Altitude-Unknown/YELLOWSTONE/LAB_NOTES_2026-06-30.md

# Yellowstone / SHERPA / ICARUS Lab Notes

Date: 2026-06-30

## What we verified

- Ground YELLOWSTONE firmware sends the cutdown command correctly.
- Ground now reports command send status in the form:
  `STATUS,CUTDOWN_SENT,<seq>,sent,<count>,timeouts,<count>`
- Airborne YELLOWSTONE receives the LoRa command and prints:
  `Command forwarded to SHERPA: CUTDOWN seq=<seq>`
- ICARUS did not receive any cutdown packet during today's end-to-end tests.

## Important fixes made today

- Ground firmware was updated so cutdown LoRa transmit does not hang forever in
  `waitPacketSent()`. It now uses a transmit timeout and reports send counts.
- Airborne firmware currently includes the larger receive window used for
  command testing.
- SHERPA PCB wiring issue was found: the UART lines had been effectively
  `TX -> TX` and `RX -> RX`.
- User corrected the SHERPA PCB/wiring before leaving the lab.

## Current conclusion

The command path is confirmed through:

- Ground USB command input
- Ground LoRa transmit
- Airborne LoRa receive
- Airborne UART output toward SHERPA

The remaining failure point is after Airborne prints
`Command forwarded to SHERPA`, meaning the likely problem area is:

- Airborne-to-SHERPA UART electrical connection
- SHERPA UART pin mapping / bridge behavior
- SHERPA ESP-NOW transmit
- ICARUS ESP-NOW receive

## Recommended first retest tomorrow

1. Connect Ground YELLOWSTONE to laptop over USB.
2. Power Airborne YELLOWSTONE with SHERPA attached.
3. Connect ICARUS to laptop over USB for monitoring.
4. Send one controlled cutdown command from Ground.
5. Watch for:
   - Ground: `STATUS,CUTDOWN_SENT,...`
   - Airborne: `Command forwarded to SHERPA...`
   - ICARUS: `ICARUS,CUTDOWN_RX...` and `ICARUS,CUTDOWN_ACTIVE...`

## Key firmware files

- `Ground_YELLOWSTONE_dev/Ground_YELLOWSTONE_dev.ino`
- `Airborne_YELLOWSTONE_dev/Airborne_YELLOWSTONE_dev.ino`
- `SHERPA_Cutdown_Bridge/SHERPA_Cutdown_Bridge.ino`
- `ICARUS_Cutdown_Receiver/ICARUS_Cutdown_Receiver.ino`
- `yellowstone_ground_station.py`

## 2026-07-01 UART correction

- Yellowstone PB22/PB23 are the SHERPA UART pins:
  - PB22 / SAMD21 package pin 37 / Arduino D30 = `Serial5` TX
  - PB23 / SAMD21 package pin 38 / Arduino D31 = `Serial5` RX
- The Feather M0 core's default `Serial1` is PA10/PA11 and does not reach the
  Yellowstone SHERPA UART connector.
- Two-Yellowstone UART diagnostics passed after switching from `Serial1` to
  `Serial5`:
  - `Yellowstone_UART_Ping_Talker`
  - `Yellowstone_UART_Ping_Responder`
- Airborne firmware was updated to forward `SHERPA,CUTDOWN,<sequence>` over
  `Serial5`.

## 2026-07-01 ICARUS acknowledgement path

- Added a reverse acknowledgement for cutdown commands:
  - ICARUS broadcasts an ESP-NOW ack after accepting a new cutdown sequence.
  - SHERPA receives `ICARUS,ACK,<sequence>,accepted,<count>` and forwards it
    to Airborne over the Yellowstone UART.
  - Airborne repeats a compact LoRa ack packet back to Ground.
  - Ground prints `STATUS,ICARUS_ACK,<sequence>,accepted,<count>,rssi,<rssi>`.
  - The GUI displays the ICARUS ack in the Cutdown panel and status bar.
- Ground transmits the cutdown command for about three seconds, so Airborne
  repeats the ack for several seconds to avoid the ack arriving only while
  Ground is still transmitting.
