Altitude-Unknown/YELLOWSTONE/SHERPA.pdf

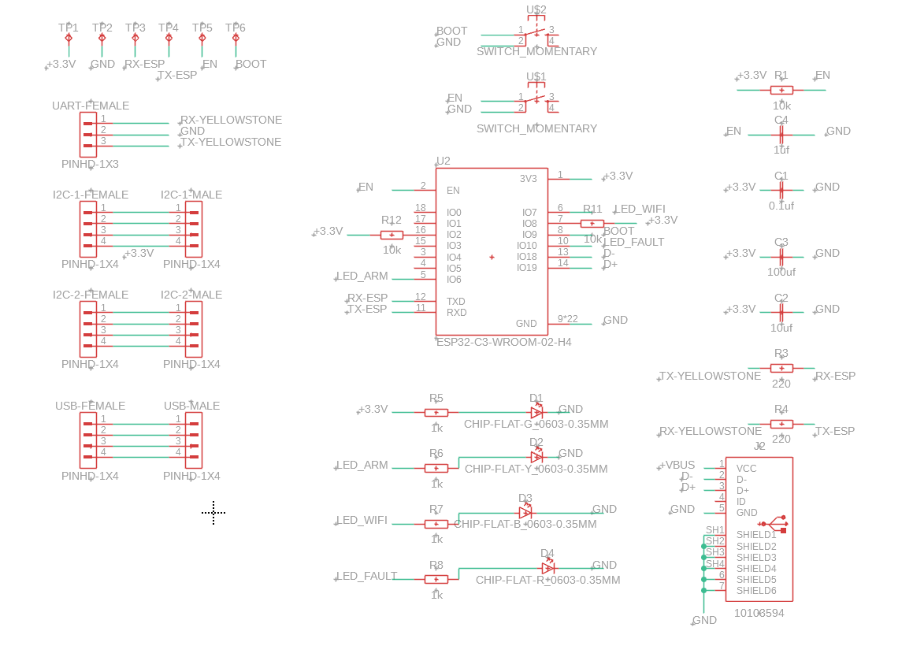
[picture p1: page 1]
