Altitude-Unknown/YELLOWSTONE/Schematic_ICARUS_cutdownSCHEMATIC_V1_DG.png

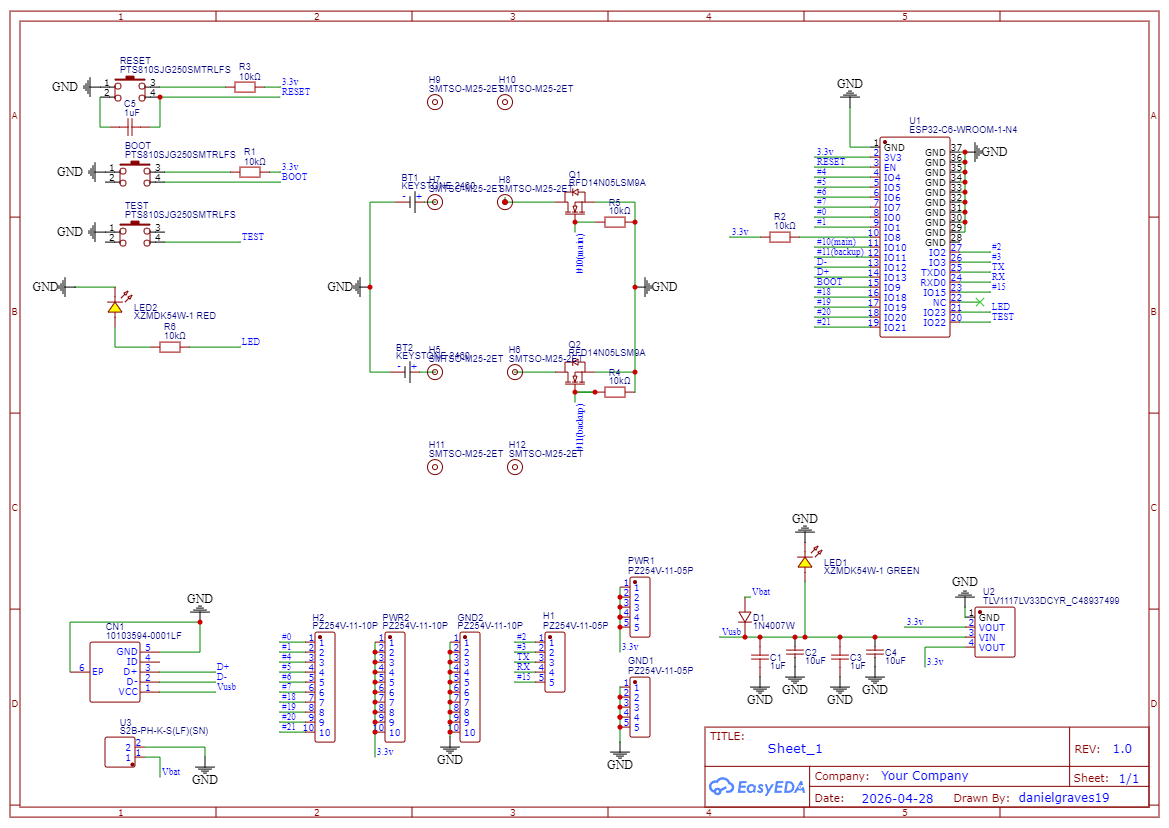
Schematic_ICARUS_cutdownSCHEMATIC_V1_DG.png
