Altitude-Unknown/YELLOWSTONE/YELLOWSTONE-V2-Schematic.pdf

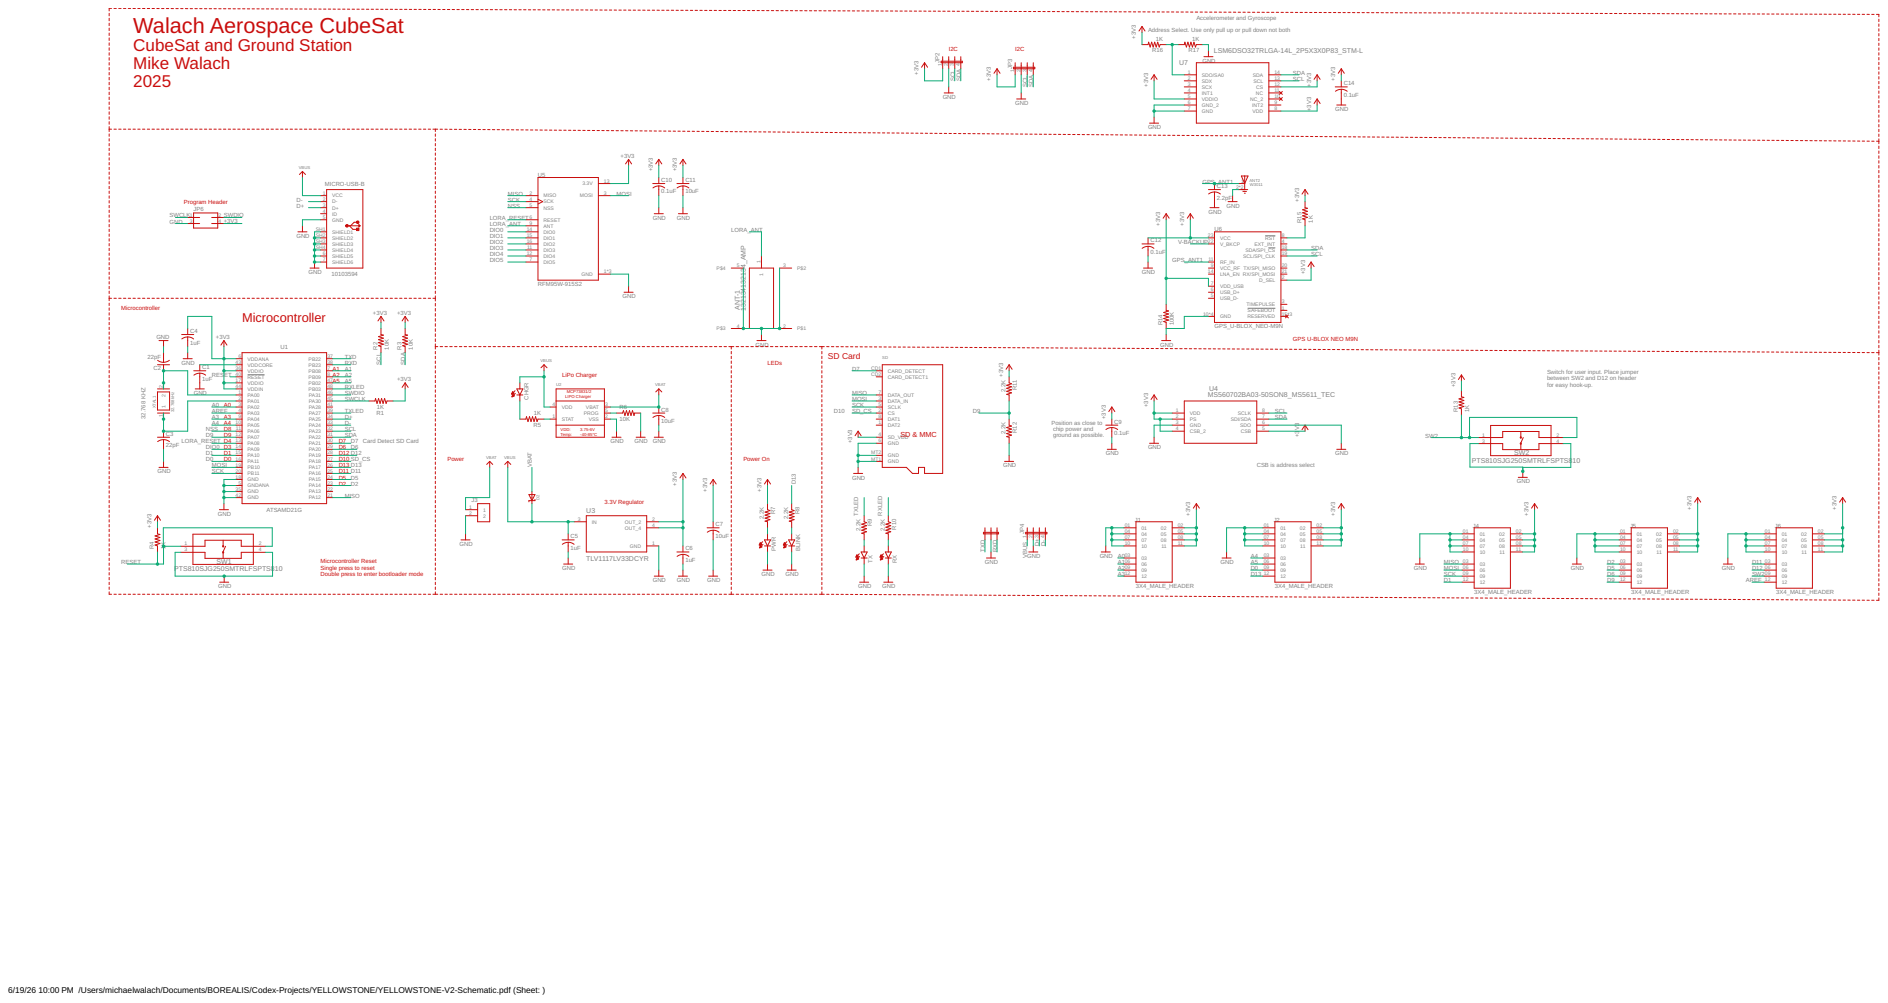
[picture p3: page 1]

Walach Aerospace CubeSat
CubeSat and Ground Station
Mike Walach

Address Select. Use only pull up or pull down not both

Switch for user input. Place jumper between SW2 and D12 on header
for easy hook-up.

Position as close to
chip power and
ground as possible.

CSB is address select

Microcontroller Reset
Single press to reset
Double press to enter bootloader mode

6/19/26 10:00 PM /Users/michaelwalach/Documents/BOREALIS/Codex-Projects/YELLOWSTONE/YELLOWSTONE-V2-Schematic.pdf (Sheet: )
