Altitude-Unknown/YELLOWSTONE/ASCEND/ASCEND_Logger_Diagnostic/ASCEND_Logger v11.pdf

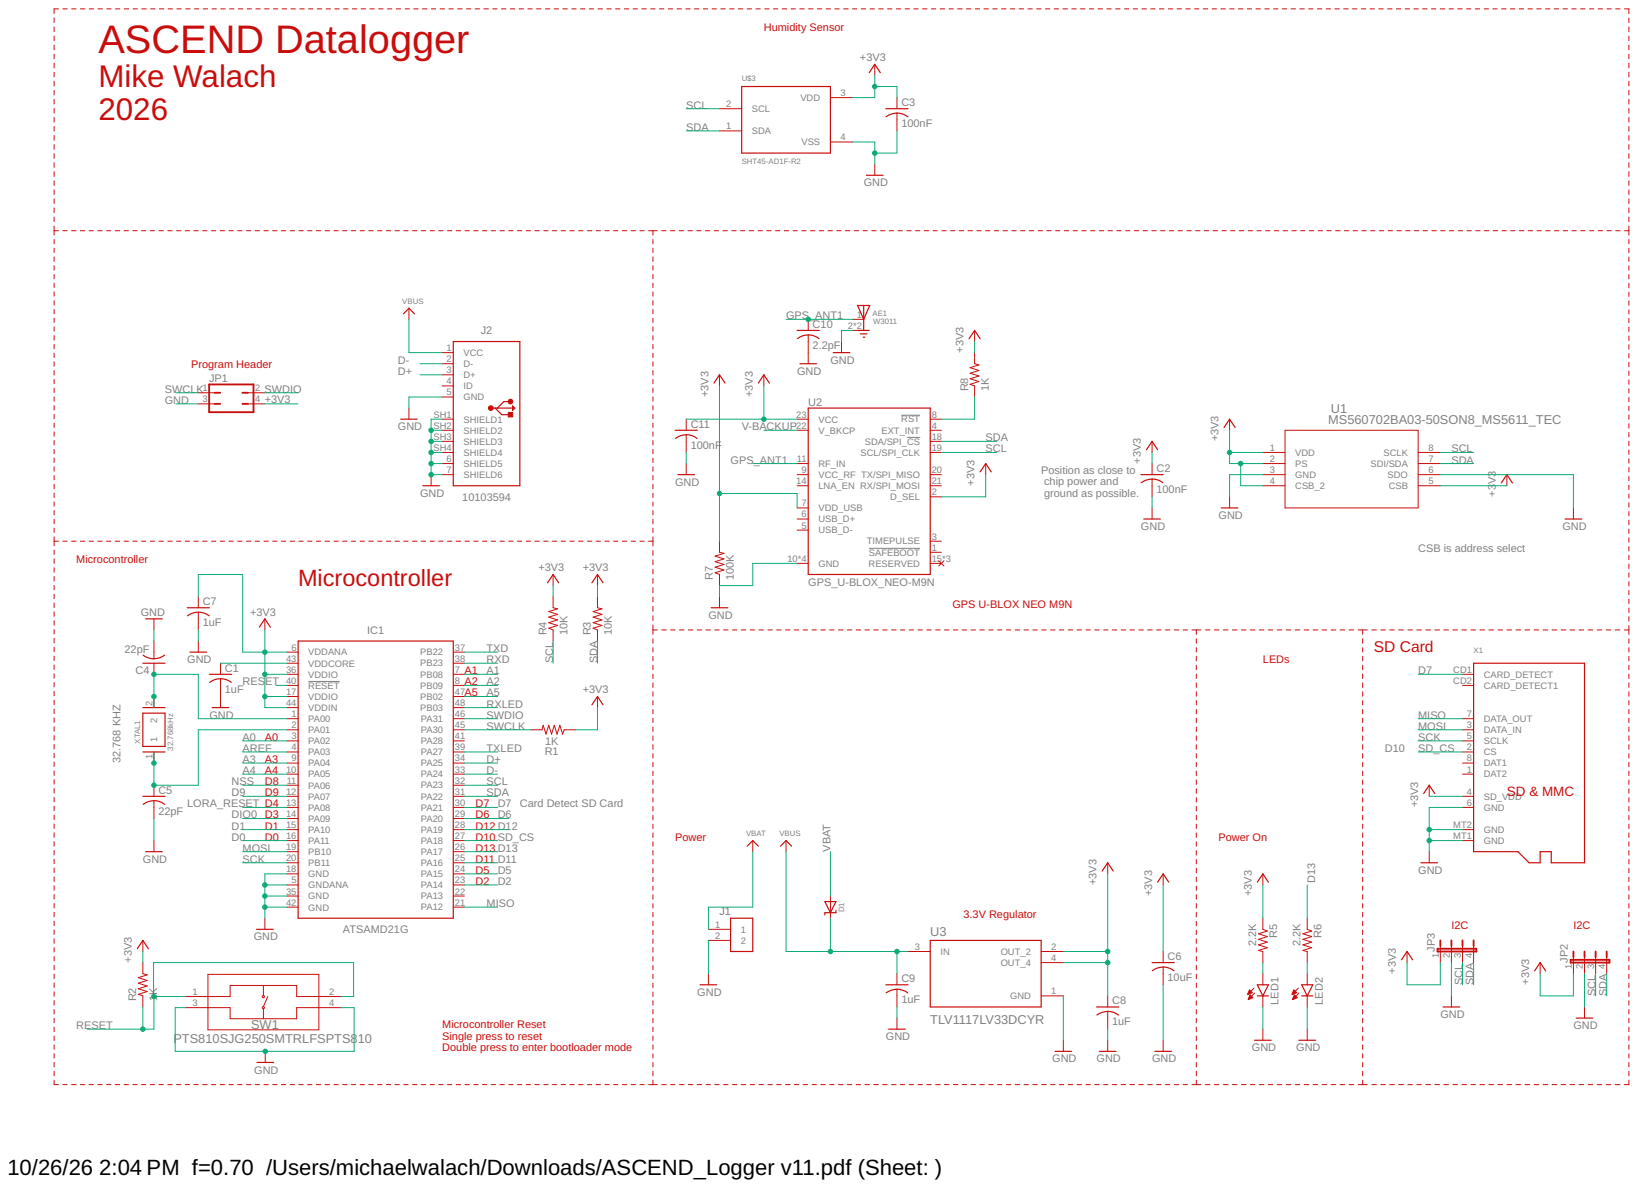
[picture p4: page 1]

Position as close to
chip power and
ground as possible.

CSB is address select

D10 Card Detect SD Card

Microcontroller Reset Single press to reset Double press to enter bootloader mode

10/26/26 2:04 PM f=0.70 /Users/michaelwalach/Downloads/ASCEND_Logger v11.pdf (Sheet: )
