Altitude-Unknown/YELLOWSTONE/ASCEND/ASCEND_Logger_Diagnostic/cad-review/ASCEND_Logger.brd

## EAGLE design ASCEND/ASCEND_Logger_Diagnostic/cad-review/ASCEND_Logger.brd (2026-11-01)

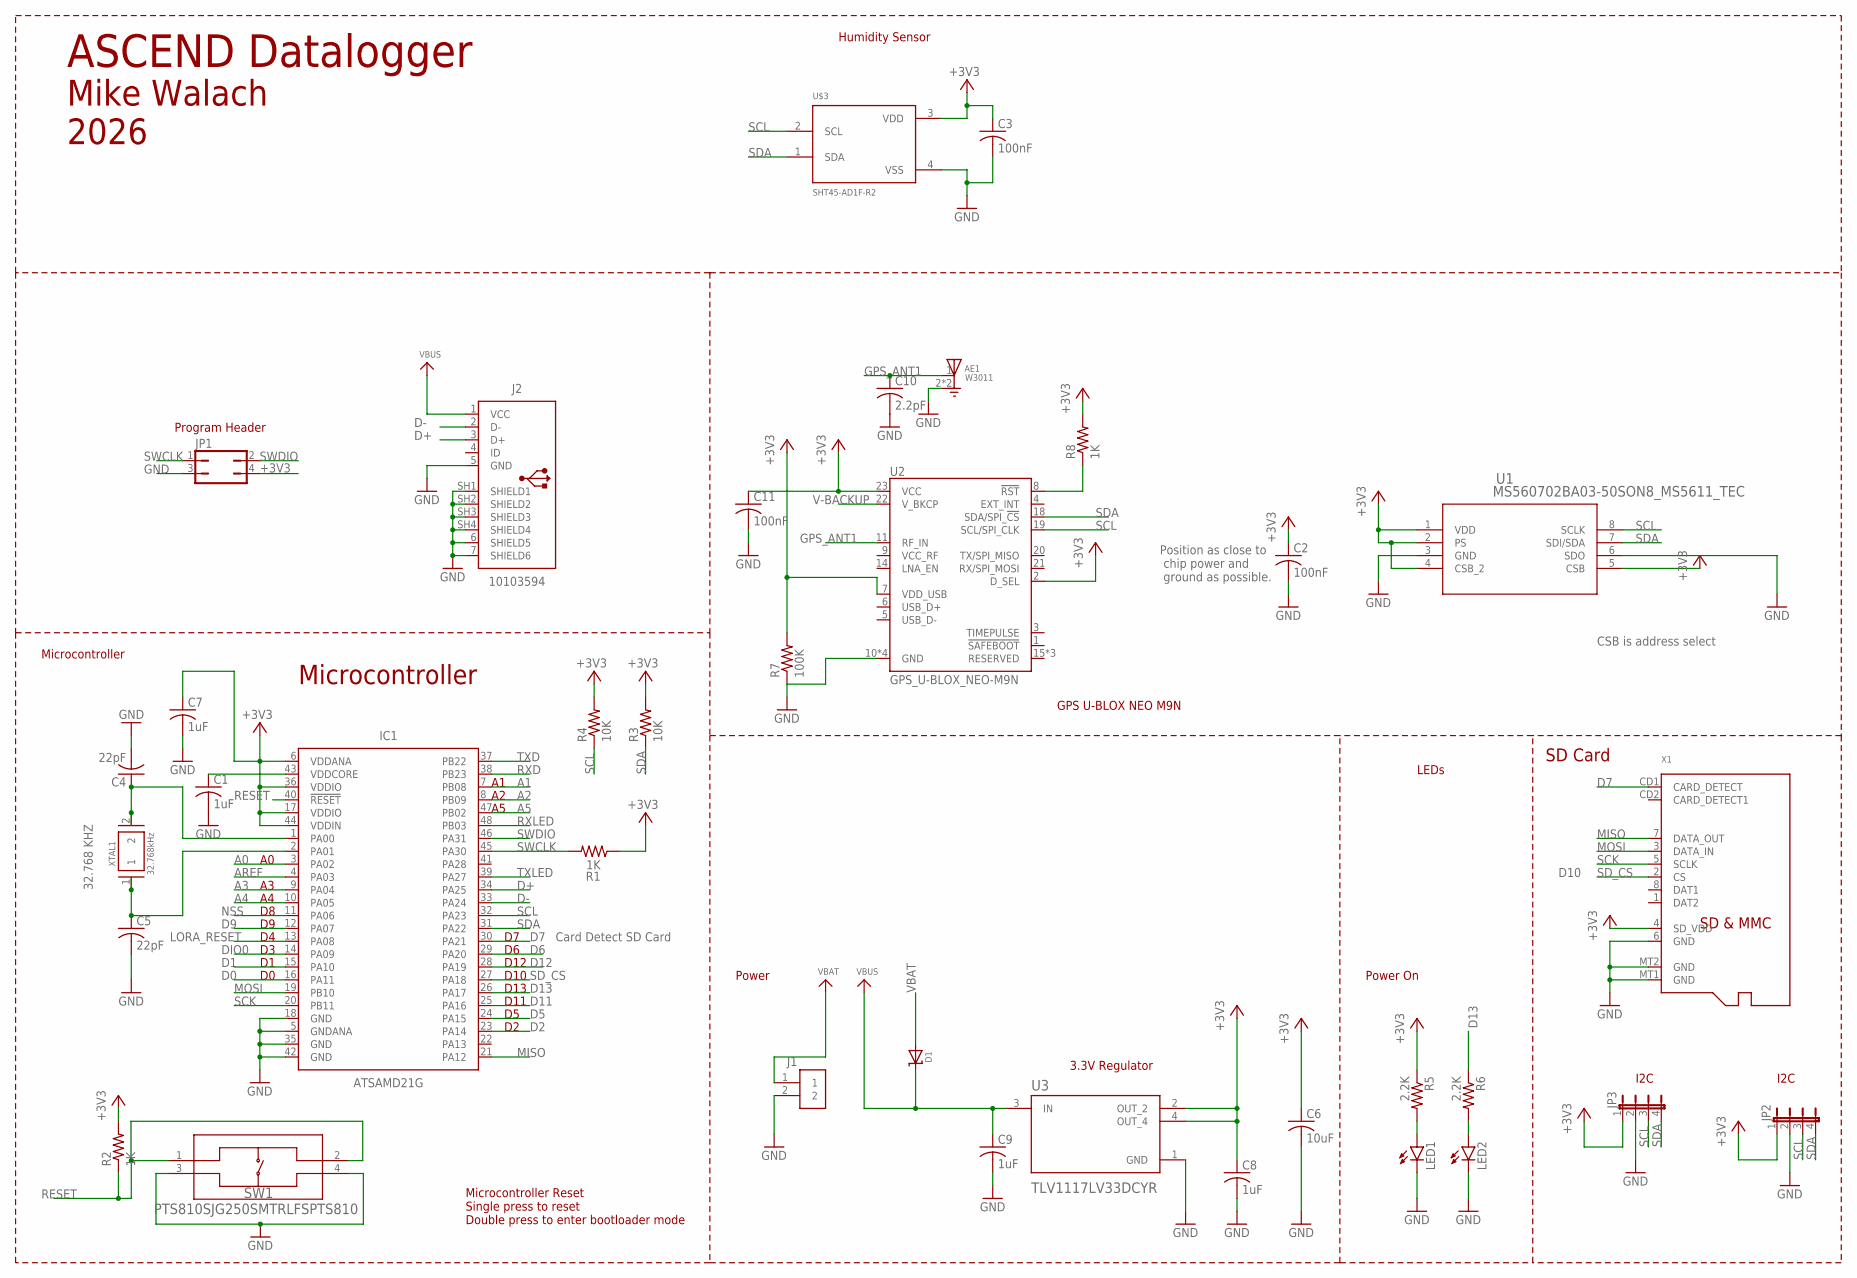
[picture p5: schematic ASCEND_Logger.sch]

Parts:
AE1: W3011; XDCR_W3011
C1, C7, C8, C9: 1uF; C0805
C2, C3, C11: 100nF; C0805
C4, C5: 22pF; C0805
C6: 10uF; C0805
C10: 2.2pF; C0805
D1: MICROBUILDER_DIODE-SCHOTTKYSOD-123; MICROBUILDER_SOD-123
IC1: ATSAMD21G; QFP50P900X900X120-48
J1: S2B-PH-K-S(LF)(SN)
J2: 10103594
JP1: JP2Q
JP2, JP3: JP4E; JP4
LED1, LED2: LEDSML0805; SML0805
R1, R2, R8: 1K; R0805
R3, R4: 10K; R0805
R5, R6: 2.2K; R0805
R7: 100K; R0805
SW1: PTS810SJG250SMTRLFSPTS810; PTS810
U1: MS560702BA03-50SON8_MS5611_TEC; SON8_MS5611_TEC
U2: GPS_U-BLOX_NEO-M9N; GPS_NEO-M9N
U3: TLV1117LV33DCYR; VREG_TLV1117LV33DCYR
U$3: SHT45-AD1F-R2; SHT4X_HAND_SOLDER
X1: MICROBUILDER_MICROSD
XTAL1: 32.768kHz; XTAL_ABS07-32.768KHZ-T

Connections:
+3V3: C2.1, C3.1, C6.1, C7.1, C8.1, C11.1, IC1.6 (VDDANA), IC1.17 (VDDIO), IC1.36 (VDDIO), IC1.44 (VDDIN), JP1.4, JP2.1, JP3.1, R1.1, R2.2, R3.2, R4.2, R5.1, R7.2, R8.2, U1.1 (VDD), U1.2 (PS), U1.4 (CSB_2), U1.5 (CSB), U2.2 (D_SEL), U2.7 (VDD_USB), U2.23 (VCC), U3.2 (OUT_2), U3.4 (OUT_4), U$3.3 (VDD), X1.4 (SD_VDD)
A0: IC1.3 (PA02)
A1: IC1.7 (PB08)
A2: IC1.8 (PB09)
A3: IC1.9 (PA04)
A4: IC1.10 (PA05)
A5: IC1.47 (PB02)
AREF: IC1.4 (PA03)
D0: IC1.16 (PA11)
D1: IC1.15 (PA10)
D2: IC1.23 (PA14)
D5: IC1.24 (PA15)
D6: IC1.29 (PA20)
D7: IC1.30 (PA21), X1.CD1 (CARD_DETECT)
D9: IC1.12 (PA07)
D11: IC1.25 (PA16)
D12: IC1.28 (PA19)
D13: IC1.26 (PA17), R6.1
D+: IC1.34 (PA25), J2.3 (D+)
D-: IC1.33 (PA24), J2.2 (D-)
DIO0: IC1.14 (PA09)
GND: AE1.2 (GND), AE1.3 (GND), C1.2, C2.2, C3.2, C4.2, C5.2, C6.2, C7.2, C8.2, C9.2, C10.2, C11.2, IC1.5 (GNDANA), IC1.18 (GND), IC1.35 (GND), IC1.42 (GND), J1.2, J2.5 (GND), J2.6 (SHIELD5), J2.7 (SHIELD6), J2.SH1 (SHIELD1), J2.SH2 (SHIELD2), J2.SH3 (SHIELD3), J2.SH4 (SHIELD4), JP1.3, JP2.2, JP3.2, LED1.C, LED2.C, R7.1, SW1.3, SW1.4, U1.3 (GND), U1.6 (SDO), U2.10 (GND), U2.12 (GND), U2.13 (GND), U2.24 (GND), U3.1 (GND), U$3.4 (VSS), X1.6 (GND), X1.MT1 (GND), X1.MT2 (GND)
GPS_ANT1: AE1.1 (FEED), C10.1, U2.11 (RF_IN)
LORA_RESET: IC1.13 (PA08)
MISO: IC1.21 (PA12), X1.7 (DATA_OUT)
MOSI: IC1.19 (PB10), X1.3 (DATA_IN)
unnamed: C1.1, IC1.43 (VDDCORE)
unnamed: LED2.A, R6.2
unnamed: R8.1, U2.8 (!RST)
unnamed: C5.1, IC1.2 (PA01), XTAL1.1
unnamed: C4.1, IC1.1 (PA00), XTAL1.2
unnamed: LED1.A, R5.2
NSS: IC1.11 (PA06)
RESET: IC1.40 (!RESET), R2.1, SW1.1, SW1.2
RXD: IC1.38 (PB23)
RXLED: IC1.48 (PB03)
SCK: IC1.20 (PB11), X1.5 (SCLK)
SCL: IC1.32 (PA23), JP2.3, JP3.3, R4.1, U1.8 (SCLK), U2.19 (SCL/SPI_CLK), U$3.2 (SCL)
SDA: IC1.31 (PA22), JP2.4, JP3.4, R3.1, U1.7 (SDI/SDA), U2.18 (SDA/SPI_!CS!), U$3.1 (SDA)
SD_CS: IC1.27 (PA18), X1.2 (CS)
SWCLK: IC1.45 (PA30), JP1.1, R1.2
SWDIO: IC1.46 (PA31), JP1.2
TXD: IC1.37 (PB22)
TXLED: IC1.39 (PA27)
V-BACKUP: U2.22 (V_BKCP)
VBAT: D1.A, J1.1
VBUS: C9.1, D1.C, J2.1 (VCC), U3.3 (IN)

Notes on the sheet:
Power
SD Card
Microcontroller
32.768 KHZ
Mike Walach 2026
D10
LEDs
Power On
Microcontroller Reset Single press to reset Double press to enter bootloader mode
ASCEND Datalogger
D13
D11
D12
I2C
Card Detect SD Card
GPS U-BLOX NEO M9N
CSB is address select
Position as close to chip power and ground as possible.
Program Header
3.3V Regulator
Humidity Sensor

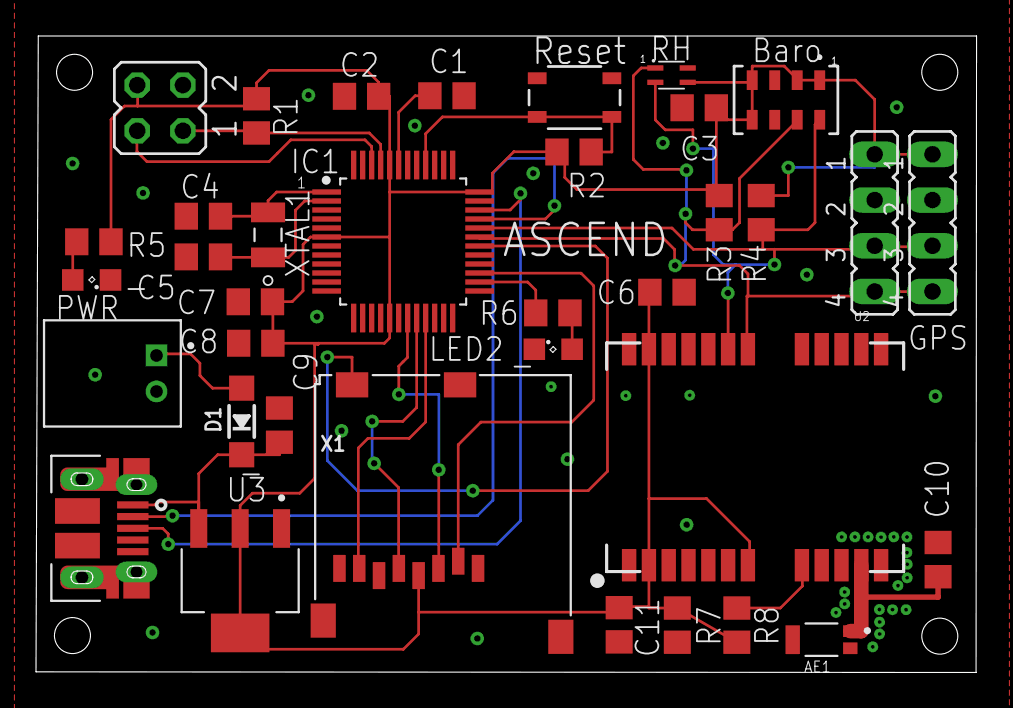
[picture p6: board ASCEND_Logger.brd from above]

Board: 2 copper layers, 52.3 x 35.4 mm, 36 parts (0 on the bottom side), 24 nets.
