Altitude-Unknown/YELLOWSTONE/yellowstone_ground_station.py

#!/usr/bin/env python3
import csv
import html
import json
import math
import os
import queue
import subprocess
import sys
import threading
import time
import webbrowser
from dataclasses import asdict, dataclass
from http.server import BaseHTTPRequestHandler, ThreadingHTTPServer
from pathlib import Path
from urllib.parse import urlparse
import tkinter as tk
from tkinter import filedialog, messagebox, ttk

try:
    import serial
    import serial.tools.list_ports as list_ports
except Exception as exc:
    raise SystemExit("This app requires pyserial. Install it with: pip install pyserial\n" + str(exc))


APP_TITLE = "Yellowstone Ground Station"
BAUD = 115200
SETTINGS_FILE = "yellowstone_ground_station_settings.json"
PUBLIC_DIR = "yellowstone_live_site"
DATA_FILE = "data.json"
INDEX_FILE = "index.html"
MAX_TABLE_ROWS = 2000
MAX_TRAIL_POINTS = 2000
MAP_SERVER_PORT = 8765

CSV_FIELDS = [
    "lat",
    "lon",
    "gps_alt_m",
    "gps_alt_ft",
    "ground_speed_mps",
    "ground_speed_mph",
    "vertical_speed_mps",
    "vertical_speed_fpm",
    "heading_deg",
    "pressure_pa",
    "pressure_hpa",
    "pressure_inhg",
    "pressure_alt_m",
    "pressure_alt_ft",
    "pressure_temp_c",
    "pressure_temp_f",
    "rssi",
    "packet",
    "date_utc",
    "time_utc",
    "fix_type",
    "sats",
    "gps_valid",
    "pressure_valid",
]

EXPORT_FIELDS = CSV_FIELDS + [
    "corrected_pressure_alt_m",
    "corrected_pressure_alt_ft",
    "distance_km",
    "distance_mi",
    "distance_nm",
    "bearing_deg_from_launch",
    "altimeter_inhg",
    "launch_name",
]

SERIAL_COMMAND_TERMINATOR = "\r\n"


def table_sash_position(total_width: int) -> int:
    """Keep both the telemetry table and the sidebar visible."""
    sidebar_width = min(420, max(340, total_width // 4))
    return max(420, total_width - sidebar_width)


class ReusableThreadingHTTPServer(ThreadingHTTPServer):
    allow_reuse_address = True


def make_map_handler(public_dir: Path):
    class MapRequestHandler(BaseHTTPRequestHandler):
        def do_GET(self):
            parsed = urlparse(self.path)
            if parsed.path in ("", "/", f"/{INDEX_FILE}"):
                self.send_file(public_dir / INDEX_FILE, "text/html; charset=utf-8")
            elif parsed.path == f"/{DATA_FILE}":
                self.send_file(public_dir / DATA_FILE, "application/json; charset=utf-8")
            else:
                self.send_error(404, "Map file not found")

        def send_file(self, path: Path, content_type: str):
            try:
                body = path.read_bytes()
            except FileNotFoundError:
                self.send_error(404, f"{path.name} not found")
                return
            except Exception as exc:
                self.send_error(500, f"Could not read {path.name}: {exc}")
                return

            self.send_response(200)
            self.send_header("Content-Type", content_type)
            self.send_header("Content-Length", str(len(body)))
            self.send_header("Cache-Control", "no-store")
            self.end_headers()
            self.wfile.write(body)

        def log_message(self, format, *args):
            return

    return MapRequestHandler


@dataclass
class TelemetryPoint:
    lat: float
    lon: float
    gps_alt_m: int
    gps_alt_ft: float
    ground_speed_mps: float
    ground_speed_mph: float
    vertical_speed_mps: float
    vertical_speed_fpm: float
    heading_deg: float
    pressure_pa: int
    pressure_hpa: float
    pressure_inhg: float
    pressure_alt_m: int
    pressure_alt_ft: float
    pressure_temp_c: float
    pressure_temp_f: float
    rssi: int
    packet: int
    date_utc: str
    time_utc: str
    fix_type: int
    sats: int
    gps_valid: int
    pressure_valid: int


def app_dir() -> Path:
    if getattr(sys, "frozen", False):
        if sys.platform == "darwin":
            return Path.home() / "Library" / "Application Support" / APP_TITLE
        if sys.platform == "win32":
            base = os.environ.get("LOCALAPPDATA") or os.environ.get("APPDATA")
            if base:
                return Path(base) / APP_TITLE
            return Path.home() / "AppData" / "Local" / APP_TITLE
        return Path(sys.executable).resolve().parent
    return Path(__file__).resolve().parent


def parse_telemetry_line(line: str) -> TelemetryPoint:
    row = next(csv.reader([line.strip()]))
    if len(row) != len(CSV_FIELDS):
        raise ValueError(f"Expected {len(CSV_FIELDS)} fields, got {len(row)}")

    return TelemetryPoint(
        lat=float(row[0]),
        lon=float(row[1]),
        gps_alt_m=int(float(row[2])),
        gps_alt_ft=float(row[3]),
        ground_speed_mps=float(row[4]),
        ground_speed_mph=float(row[5]),
        vertical_speed_mps=float(row[6]),
        vertical_speed_fpm=float(row[7]),
        heading_deg=float(row[8]),
        pressure_pa=int(float(row[9])),
        pressure_hpa=float(row[10]),
        pressure_inhg=float(row[11]),
        pressure_alt_m=int(float(row[12])),
        pressure_alt_ft=float(row[13]),
        pressure_temp_c=float(row[14]),
        pressure_temp_f=float(row[15]),
        rssi=int(float(row[16])),
        packet=int(float(row[17])),
        date_utc=row[18],
        time_utc=row[19],
        fix_type=int(float(row[20])),
        sats=int(float(row[21])),
        gps_valid=int(float(row[22])),
        pressure_valid=int(float(row[23])),
    )


def corrected_pressure_altitude_ft(pressure_alt_ft: float, altimeter_inhg: float) -> float:
    return pressure_alt_ft + (altimeter_inhg - 29.92) * 1000.0


def corrected_pressure_altitude_m(pressure_alt_m: float, altimeter_inhg: float) -> float:
    return corrected_pressure_altitude_ft(pressure_alt_m * 3.28084, altimeter_inhg) / 3.28084


def haversine_distance_km(lat1: float, lon1: float, lat2: float, lon2: float) -> float:
    radius_km = 6371.0
    phi1 = math.radians(lat1)
    phi2 = math.radians(lat2)
    dphi = math.radians(lat2 - lat1)
    dlambda = math.radians(lon2 - lon1)
    a = math.sin(dphi / 2.0) ** 2 + math.cos(phi1) * math.cos(phi2) * math.sin(dlambda / 2.0) ** 2
    return 2.0 * radius_km * math.atan2(math.sqrt(a), math.sqrt(1.0 - a))


def initial_bearing_deg(lat1: float, lon1: float, lat2: float, lon2: float) -> float:
    phi1 = math.radians(lat1)
    phi2 = math.radians(lat2)
    dlambda = math.radians(lon2 - lon1)
    y = math.sin(dlambda) * math.cos(phi2)
    x = math.cos(phi1) * math.sin(phi2) - math.sin(phi1) * math.cos(phi2) * math.cos(dlambda)
    return (math.degrees(math.atan2(y, x)) + 360.0) % 360.0


class SerialReader(threading.Thread):
    def __init__(self, port: str, out_queue: queue.Queue, command_queue: queue.Queue, stop_event: threading.Event):
        super().__init__(daemon=True)
        self.port = port
        self.out_queue = out_queue
        self.command_queue = command_queue
        self.stop_event = stop_event

    def write_pending_commands(self, ser):
        while True:
            try:
                command = self.command_queue.get_nowait()
            except queue.Empty:
                return
            encoded = (command.strip() + SERIAL_COMMAND_TERMINATOR).encode("ascii")
            written = ser.write(encoded)
            ser.flush()
            if written != len(encoded):
                raise serial.SerialTimeoutException(
                    f"Incomplete serial command write: {written} of {len(encoded)} bytes"
                )
            self.out_queue.put(("status", f"Sent command: {command} ({written} bytes)"))

    def run(self):
        try:
            with serial.Serial(self.port, BAUD, timeout=0.5, write_timeout=2.0) as ser:
                time.sleep(0.25)
                ser.reset_input_buffer()
                self.out_queue.put(("status", f"Connected to {self.port}"))
                while not self.stop_event.is_set():
                    self.write_pending_commands(ser)
                    raw = ser.readline()
                    self.write_pending_commands(ser)
                    if not raw:
                        continue
                    line = raw.decode("utf-8", errors="replace").strip()
                    if not line:
                        continue
                    try:
                        point = parse_telemetry_line(line)
                    except Exception:
                        self.out_queue.put(("raw", line))
                    else:
                        self.out_queue.put(("telemetry", point))
        except Exception as exc:
            self.out_queue.put(("error", f"Serial error: {exc}"))


class GroundStationApp(tk.Tk):
    def __init__(self):
        super().__init__()
        self.title(APP_TITLE)
        self.geometry("1280x760")
        self.minsize(980, 620)

        self.base_dir = app_dir()
        self.public_dir = self.base_dir / PUBLIC_DIR
        self.settings_path = self.base_dir / SETTINGS_FILE
        self.settings = self.load_settings()

        self.serial_queue = queue.Queue()
        self.command_queue = queue.Queue()
        self.stop_event = threading.Event()
        self.reader = None
        self.points = []
        self.all_points = []
        self.latest_point = None
        self.last_publish = 0.0
        self.auto_publish_job = None
        self.map_server = None
        self.map_server_thread = None
        self.map_server_port = MAP_SERVER_PORT
        self._layout_attempts_remaining = 3

        self.port_var = tk.StringVar()
        self.status_var = tk.StringVar(value="Not connected")
        self.cutdown_ack_var = tk.StringVar(value="No ICARUS ack yet")
        self.ping_status_var = tk.StringVar(value="No ping sent yet")
        self.map_status_var = tk.StringVar(value="No valid GPS point yet")
        self.netlify_site_var = tk.StringVar(value=self.settings.get("netlify_site_id", ""))
        self.netlify_token_var = tk.StringVar(value=self.settings.get("netlify_auth_token", ""))
        self.publish_interval_var = tk.IntVar(value=int(self.settings.get("publish_interval_sec", 60)))
        self.auto_publish_var = tk.BooleanVar(value=bool(self.settings.get("auto_publish", False)))
        self.altimeter_var = tk.StringVar(value=str(self.settings.get("altimeter_inhg", 29.92)))
        self.launch_name_var = tk.StringVar(value=self.settings.get("launch_name", ""))
        self.launch_lat_var = tk.StringVar(value=self.settings.get("launch_lat", ""))
        self.launch_lon_var = tk.StringVar(value=self.settings.get("launch_lon", ""))

        self.build_ui()
        self.refresh_ports()
        self.ensure_public_site()
        self.after(50, self.enforce_panel_layout)
        self.after(100, self.process_serial_queue)

    def load_settings(self):
        try:
            return json.loads(self.settings_path.read_text(encoding="utf-8"))
        except Exception:
            return {}

    def save_settings(self):
        self.settings.update(
            {
                "netlify_site_id": self.netlify_site_var.get().strip(),
                "netlify_auth_token": self.netlify_token_var.get().strip(),
                "publish_interval_sec": int(self.publish_interval_var.get()),
                "auto_publish": bool(self.auto_publish_var.get()),
                "altimeter_inhg": self.get_altimeter_setting(),
                "launch_name": self.launch_name_var.get().strip(),
                "launch_lat": self.launch_lat_var.get().strip(),
                "launch_lon": self.launch_lon_var.get().strip(),
            }
        )
        self.settings_path.write_text(json.dumps(self.settings, indent=2), encoding="utf-8")
        self.status_var.set("Settings saved")

    def build_ui(self):
        root = ttk.Frame(self, padding=10)
        root.pack(fill="both", expand=True)

        top = ttk.Frame(root)
        top.pack(fill="x")

        ttk.Label(top, text="Serial Port").pack(side="left")
        self.port_box = ttk.Combobox(top, textvariable=self.port_var, width=36, state="readonly")
        self.port_box.pack(side="left", padx=6)
        ttk.Button(top, text="Refresh", command=self.refresh_ports).pack(side="left")
        self.connect_btn = ttk.Button(top, text="Connect", command=self.toggle_connection)
        self.connect_btn.pack(side="left", padx=6)
        self.add_top_menu(top, "View", (("Reset Table Layout", self.reset_table_layout),))
        self.add_top_menu(top, "Map", (("Open Live Map", self.open_map), ("Choose Public Folder", self.choose_public_dir)))
        self.add_top_menu(top, "Export", (("Export CSV", self.export_csv), ("Export KML", self.export_kml)))
        self.add_top_menu(top, "Publish", (("Publish Now", self.publish_now), ("Save Settings", self.save_settings)))

        panes = ttk.Panedwindow(root, orient="horizontal")
        panes.pack(fill="both", expand=True, pady=(10, 0))
        self.panes = panes

        left = ttk.Frame(panes)
        right = ttk.Frame(panes)
        right.configure(width=420)
        panes.add(left, weight=3)
        panes.add(right, weight=1)
        self.right_panel = right

        cutdown_box = ttk.LabelFrame(right, text="Cutdown", padding=10)
        cutdown_box.pack(fill="x")
        self.cutdown_side_btn = ttk.Button(
            cutdown_box,
            text="Send Cutdown",
            command=self.send_cutdown_command,
            state="disabled",
        )
        self.cutdown_side_btn.pack(fill="x")
        ttk.Label(cutdown_box, textvariable=self.cutdown_ack_var, wraplength=360, justify="left").pack(fill="x", pady=(8, 0))

        ping_box = ttk.LabelFrame(right, text="End-to-End Link Test", padding=10)
        ping_box.pack(fill="x", pady=(10, 0))
        self.ping_side_btn = ttk.Button(
            ping_box,
            text="Ping ICARUS",
            command=self.send_ping_command,
            state="disabled",
        )
        self.ping_side_btn.pack(fill="x")
        ttk.Label(ping_box, textvariable=self.ping_status_var, wraplength=360, justify="left").pack(fill="x", pady=(8, 0))

        columns = CSV_FIELDS
        self.table = ttk.Treeview(left, columns=columns, show="headings", height=24)
        for col in columns:
            self.table.heading(col, text=col)
            width = 92
            if col in ("date_utc", "time_utc"):
                width = 104
            elif col in ("lat", "lon"):
                width = 112
            elif col in ("heading_deg", "pressure_inhg"):
                width = 108
            elif col in ("pressure_pa", "gps_alt_ft", "pressure_alt_ft", "vertical_speed_fpm"):
                width = 116
            self.table.column(col, width=width, anchor="center", stretch=False)

        yscroll = ttk.Scrollbar(left, orient="vertical", command=self.table.yview)
        xscroll = ttk.Scrollbar(left, orient="horizontal", command=self.table.xview)
        self.table.configure(yscrollcommand=yscroll.set, xscrollcommand=xscroll.set)
        self.table.grid(row=0, column=0, sticky="nsew")
        yscroll.grid(row=0, column=1, sticky="ns")
        xscroll.grid(row=1, column=0, sticky="ew")
        left.rowconfigure(0, weight=1)
        left.columnconfigure(0, weight=1)

        telemetry = ttk.LabelFrame(right, text="Live Telemetry", padding=10)
        telemetry.pack(fill="x", pady=(10, 0))
        self.live_labels = {}
        for label in (
            "Lat",
            "Lon",
            "GPS Altitude",
            "Pressure Altitude",
            "Corrected Altitude",
            "Ground Speed",
            "Vertical Speed",
            "Heading",
            "Pressure",
            "Temperature",
            "Range / Bearing",
            "RSSI",
            "Packet",
            "UTC",
            "Fix",
            "Sats",
        ):
            row = ttk.Frame(telemetry)
            row.pack(fill="x", pady=2)
            ttk.Label(row, text=label, width=12).pack(side="left")
            var = tk.StringVar(value="-")
            ttk.Label(row, textvariable=var, wraplength=300, justify="left").pack(side="left")
            self.live_labels[label] = var

        reference = ttk.LabelFrame(right, text="Reference", padding=10)
        reference.pack(fill="x", pady=(10, 0))
        alt_row = ttk.Frame(reference)
        alt_row.pack(fill="x", pady=(0, 6))
        ttk.Label(alt_row, text="Altimeter inHg", width=14).pack(side="left")
        ttk.Entry(alt_row, textvariable=self.altimeter_var, width=10).pack(side="left")
        launch_name_row = ttk.Frame(reference)
        launch_name_row.pack(fill="x", pady=(0, 6))
        ttk.Label(launch_name_row, text="Launch Name", width=14).pack(side="left")
        ttk.Entry(launch_name_row, textvariable=self.launch_name_var).pack(side="left", fill="x", expand=True)
        launch_lat_row = ttk.Frame(reference)
        launch_lat_row.pack(fill="x", pady=(0, 6))
        ttk.Label(launch_lat_row, text="Launch Lat", width=14).pack(side="left")
        ttk.Entry(launch_lat_row, textvariable=self.launch_lat_var, width=16).pack(side="left")
        launch_lon_row = ttk.Frame(reference)
        launch_lon_row.pack(fill="x", pady=(0, 6))
        ttk.Label(launch_lon_row, text="Launch Lon", width=14).pack(side="left")
        ttk.Entry(launch_lon_row, textvariable=self.launch_lon_var, width=16).pack(side="left")
        ttk.Button(reference, text="Use Latest GPS As Launch", command=self.use_latest_as_launch).pack(fill="x")

        map_box = ttk.LabelFrame(right, text="Map", padding=10)
        map_box.pack(fill="x", pady=(10, 0))
        ttk.Label(map_box, textvariable=self.map_status_var, wraplength=300).pack(fill="x")
        ttk.Button(map_box, text="Open Live Map In Browser", command=self.open_map).pack(fill="x", pady=(8, 0))
        ttk.Button(map_box, text="Choose Public Folder", command=self.choose_public_dir).pack(fill="x", pady=(6, 0))

        netlify = ttk.LabelFrame(right, text="Netlify", padding=10)
        netlify.pack(fill="x", pady=(10, 0))
        ttk.Label(netlify, text="Site ID").pack(anchor="w")
        ttk.Entry(netlify, textvariable=self.netlify_site_var).pack(fill="x", pady=(0, 6))
        ttk.Label(netlify, text="Auth Token").pack(anchor="w")
        ttk.Entry(netlify, textvariable=self.netlify_token_var, show="*").pack(fill="x", pady=(0, 6))
        interval_row = ttk.Frame(netlify)
        interval_row.pack(fill="x", pady=(2, 6))
        ttk.Label(interval_row, text="Publish every").pack(side="left")
        ttk.Spinbox(interval_row, from_=15, to=600, increment=15, width=7, textvariable=self.publish_interval_var).pack(side="left", padx=6)
        ttk.Label(interval_row, text="sec").pack(side="left")
        ttk.Checkbutton(netlify, text="Auto publish", variable=self.auto_publish_var, command=self.on_auto_publish_changed).pack(anchor="w")
        ttk.Button(netlify, text="Save Settings", command=self.save_settings).pack(fill="x", pady=(6, 0))
        ttk.Button(netlify, text="Publish Now", command=self.publish_now).pack(fill="x", pady=(6, 0))

        help_box = ttk.LabelFrame(right, text="Files", padding=10)
        help_box.pack(fill="both", expand=True, pady=(10, 0))
        self.public_dir_var = tk.StringVar(value=str(self.public_dir))
        ttk.Label(help_box, textvariable=self.public_dir_var, wraplength=300).pack(fill="x")

        status_bar = ttk.Frame(root)
        status_bar.pack(fill="x", pady=(8, 0))
        ttk.Label(status_bar, textvariable=self.status_var, anchor="w").pack(side="left", fill="x", expand=True)

    def add_top_menu(self, parent, label, items):
        button = ttk.Menubutton(parent, text=label)
        menu = tk.Menu(button, tearoff=False)
        for item_label, command in items:
            menu.add_command(label=item_label, command=command)
        button.configure(menu=menu)
        button.pack(side="left", padx=(12, 0))
        return button

    def enforce_panel_layout(self):
        try:
            total_width = self.panes.winfo_width()
            if total_width <= 0:
                self.after(100, self.enforce_panel_layout)
                return
            self.panes.sashpos(0, table_sash_position(total_width))
        except Exception as exc:
            self.status_var.set(f"Could not position telemetry table: {exc}")
        finally:
            # Windows can report the initial widget size before DPI/layout
            # negotiation completes. Retry only during startup so a user's
            # later splitter adjustment remains intact.
            if self._layout_attempts_remaining > 0:
                self._layout_attempts_remaining -= 1
                self.after(250, self.enforce_panel_layout)

    def reset_table_layout(self):
        """Restore the telemetry table if the splitter has collapsed it."""
        self.update_idletasks()
        try:
            total_width = self.panes.winfo_width()
            if total_width <= 0:
                raise RuntimeError("window has not finished sizing")
            self.panes.sashpos(0, table_sash_position(total_width))
            self.status_var.set("Telemetry table layout reset")
        except Exception as exc:
            self.status_var.set(f"Could not reset telemetry table layout: {exc}")

    def refresh_ports(self):
        ports = [p.device for p in list_ports.comports()]
        self.port_box["values"] = ports
        if ports and self.port_var.get() not in ports:
            self.port_var.set(ports[0])
        self.status_var.set(f"Found {len(ports)} serial port(s)")

    def toggle_connection(self):
        if self.reader:
            self.disconnect()
        else:
            self.connect()

    def connect(self):
        port = self.port_var.get().strip()
        if not port:
            messagebox.showwarning(APP_TITLE, "Choose a serial port first.")
            return
        self.stop_event.clear()
        self.reader = SerialReader(port, self.serial_queue, self.command_queue, self.stop_event)
        self.reader.start()
        self.connect_btn.configure(text="Disconnect")
        self.cutdown_side_btn.configure(state="normal")
        self.ping_side_btn.configure(state="normal")
        self.status_var.set(f"Opening {port}")

    def disconnect(self):
        self.stop_event.set()
        self.reader = None
        self.connect_btn.configure(text="Connect")
        self.cutdown_side_btn.configure(state="disabled")
        self.ping_side_btn.configure(state="disabled")
        self.status_var.set("Disconnected")

    def send_cutdown_command(self):
        if not self.reader:
            messagebox.showwarning(APP_TITLE, "Connect to the ground Yellowstone serial port first.")
            return

        confirmed = messagebox.askyesno(
            APP_TITLE,
            "Send CUTDOWN command to the airborne Yellowstone and SHERPA?\n\n"
            "This should only be used when you intend to activate the flight termination system.",
            icon="warning",
        )
        if not confirmed:
            self.status_var.set("Cutdown command cancelled")
            return

        self.command_queue.put("CMD,CUTDOWN")
        self.cutdown_ack_var.set("Waiting for ICARUS acknowledgement")
        self.status_var.set("Queued cutdown command")

    def send_ping_command(self):
        if not self.reader:
            messagebox.showwarning(APP_TITLE, "Connect to the ground Yellowstone serial port first.")
            return
        self.command_queue.put("CMD,PING")
        self.ping_status_var.set("Waiting: Ground → Airborne → SHERPA → ICARUS")
        self.status_var.set("Queued end-to-end ping")

    def process_serial_queue(self):
        while True:
            try:
                kind, value = self.serial_queue.get_nowait()
            except queue.Empty:
                break

            if kind == "telemetry":
                self.add_telemetry(value)
            elif kind == "status":
                self.status_var.set(value)
            elif kind == "raw":
                if value.startswith("STATUS,COMMAND_SENT,"):
                    parts = value.split(",")
                    command = parts[2] if len(parts) > 2 else "?"
                    sequence = parts[3] if len(parts) > 3 else "?"
                    sent = parts[5] if len(parts) > 5 else "?"
                    self.status_var.set(f"{command} seq {sequence}: ground transmitted {sent} copies")
                    if command == "CUTDOWN":
                        self.cutdown_ack_var.set(f"CUTDOWN seq {sequence}: waiting for hop acknowledgements")
                    elif command == "PING":
                        self.ping_status_var.set(f"PING seq {sequence}: ground sent; waiting for Airborne")
                elif value.startswith("STATUS,COMMAND_ACK,"):
                    parts = value.split(",")
                    command = parts[2] if len(parts) > 2 else "?"
                    sequence = parts[3] if len(parts) > 3 else "?"
                    stage = parts[5] if len(parts) > 5 else "?"
                    status = parts[7] if len(parts) > 7 else "?"
                    rssi = parts[11] if len(parts) > 11 else "?"
                    message = f"{command} seq {sequence}: {stage} ack status {status} | LoRa RSSI {rssi} dBm"
                    self.status_var.set(message)
                    if command == "CUTDOWN":
                        self.cutdown_ack_var.set(message)
                    elif command == "PING":
                        if stage == "ICARUS" and status == "1":
                            message = f"PING seq {sequence}: END-TO-END PASS through ICARUS | RSSI {rssi} dBm"
                        self.ping_status_var.set(message)
                elif value.startswith("STATUS,"):
                    self.status_var.set(value)
                else:
                    self.status_var.set(f"Ignored serial text: {value[:80]}")
            elif kind == "error":
                self.status_var.set(value)
                self.disconnect()

        self.after(100, self.process_serial_queue)

    def get_altimeter_setting(self) -> float:
        try:
            value = float(self.altimeter_var.get().strip())
        except Exception:
            value = 29.92
        if value < 25.0 or value > 35.0:
            return 29.92
        return value

    def get_launch_reference(self):
        try:
            lat = float(self.launch_lat_var.get().strip())
            lon = float(self.launch_lon_var.get().strip())
        except Exception:
            return None
        return lat, lon

    def use_latest_as_launch(self):
        point = self.latest_point
        if not point or not point.gps_valid:
            messagebox.showwarning(APP_TITLE, "A valid GPS point is required before using the latest location as launch.")
            return
        self.launch_lat_var.set(f"{point.lat:.7f}")
        self.launch_lon_var.set(f"{point.lon:.7f}")
        if not self.launch_name_var.get().strip():
            self.launch_name_var.set("Launch Point")
        self.save_settings()
        self.status_var.set("Saved current GPS position as launch reference")

    def build_derived_fields(self, point: TelemetryPoint):
        altimeter_inhg = self.get_altimeter_setting()
        corrected_ft = corrected_pressure_altitude_ft(point.pressure_alt_ft, altimeter_inhg)
        corrected_m = corrected_ft / 3.28084

        distance_km = None
        distance_mi = None
        distance_nm = None
        bearing_deg = None
        launch_ref = self.get_launch_reference()
        if launch_ref and point.gps_valid:
            launch_lat, launch_lon = launch_ref
            distance_km = haversine_distance_km(launch_lat, launch_lon, point.lat, point.lon)
            distance_mi = distance_km * 0.621371
            distance_nm = distance_km * 0.539957
            bearing_deg = initial_bearing_deg(launch_lat, launch_lon, point.lat, point.lon)

        return {
            "corrected_pressure_alt_m": corrected_m,
            "corrected_pressure_alt_ft": corrected_ft,
            "distance_km": distance_km,
            "distance_mi": distance_mi,
            "distance_nm": distance_nm,
            "bearing_deg_from_launch": bearing_deg,
            "altimeter_inhg": altimeter_inhg,
            "launch_name": self.launch_name_var.get().strip(),
        }

    def point_export_row(self, point: TelemetryPoint):
        row = asdict(point)
        row.update(self.build_derived_fields(point))
        return row

    def add_telemetry(self, point: TelemetryPoint):
        self.latest_point = point
        self.all_points.append(point)
        if point.gps_valid:
            self.points.append(point)
            if len(self.points) > MAX_TRAIL_POINTS:
                self.points = self.points[-MAX_TRAIL_POINTS:]

        values = [getattr(point, field) for field in CSV_FIELDS]
        self.table.insert("", "end", values=values)
        children = self.table.get_children()
        if len(children) > MAX_TABLE_ROWS:
            self.table.delete(children[0])
        self.table.yview_moveto(1.0)
        self.update_live_labels(point)
        self.write_live_data()

        if self.auto_publish_var.get():
            now = time.time()
            interval = max(15, int(self.publish_interval_var.get()))
            if now - self.last_publish >= interval:
                self.last_publish = now
                self.publish_now()

    def update_live_labels(self, point: TelemetryPoint):
        derived = self.build_derived_fields(point)
        self.live_labels["Lat"].set(f"{point.lat:.7f}")
        self.live_labels["Lon"].set(f"{point.lon:.7f}")
        self.live_labels["GPS Altitude"].set(f"{point.gps_alt_m} m | {point.gps_alt_ft:.1f} ft")
        self.live_labels["Pressure Altitude"].set(f"{point.pressure_alt_m} m | {point.pressure_alt_ft:.1f} ft")
        self.live_labels["Corrected Altitude"].set(
            f"{derived['corrected_pressure_alt_m']:.0f} m | {derived['corrected_pressure_alt_ft']:.1f} ft @ {derived['altimeter_inhg']:.2f} inHg"
        )
        self.live_labels["Ground Speed"].set(f"{point.ground_speed_mps:.2f} m/s | {point.ground_speed_mph:.2f} mph")
        self.live_labels["Vertical Speed"].set(f"{point.vertical_speed_mps:.2f} m/s | {point.vertical_speed_fpm:.0f} fpm")
        self.live_labels["Heading"].set(f"{point.heading_deg:.1f}")
        self.live_labels["Pressure"].set(f"{point.pressure_pa} Pa | {point.pressure_hpa:.2f} hPa | {point.pressure_inhg:.4f} inHg")
        self.live_labels["Temperature"].set(f"{point.pressure_temp_c:.2f} C | {point.pressure_temp_f:.2f} F")
        if derived["distance_km"] is not None and derived["bearing_deg_from_launch"] is not None:
            launch_name = derived["launch_name"] or "launch"
            self.live_labels["Range / Bearing"].set(
                f"{derived['distance_nm']:.2f} nm @ {derived['bearing_deg_from_launch']:.1f} deg from {launch_name} | {derived['distance_mi']:.2f} mi | {derived['distance_km']:.2f} km"
            )
        elif self.get_launch_reference() and not point.gps_valid:
            self.live_labels["Range / Bearing"].set("Waiting for valid GPS fix")
        else:
            self.live_labels["Range / Bearing"].set("Enter launch lat/lon to compute")
        self.live_labels["RSSI"].set(str(point.rssi))
        self.live_labels["Packet"].set(str(point.packet))
        self.live_labels["UTC"].set(f"{point.date_utc} {point.time_utc}")
        self.live_labels["Fix"].set(str(point.fix_type))
        self.live_labels["Sats"].set(str(point.sats))
        if point.gps_valid:
            self.map_status_var.set(f"Map tracking packet {point.packet} at {point.date_utc} {point.time_utc} UTC")
        elif point.pressure_valid:
            self.map_status_var.set(f"Pressure valid on packet {point.packet}; waiting for valid GPS fix")
        else:
            self.map_status_var.set("Waiting for valid 3D GPS fix")

    def ensure_public_site(self):
        self.public_dir.mkdir(parents=True, exist_ok=True)
        index_path = self.public_dir / INDEX_FILE
        index_path.write_text(map_html(), encoding="utf-8")
        self.write_live_data()
        self.public_dir_var.set(str(self.public_dir))

    def choose_public_dir(self):
        chosen = filedialog.askdirectory(initialdir=str(self.public_dir.parent))
        if not chosen:
            return
        self.public_dir = Path(chosen)
        self.ensure_public_site()

    def write_live_data(self):
        self.public_dir.mkdir(parents=True, exist_ok=True)
        latest = asdict(self.latest_point) if self.latest_point else None
        trail = [asdict(point) for point in self.points[-MAX_TRAIL_POINTS:]]
        payload = {
            "generated_utc": time.strftime("%Y-%m-%dT%H:%M:%SZ", time.gmtime()),
            "latest": latest,
            "latest_display": self.build_derived_fields(self.latest_point) if self.latest_point else None,
            "launch_reference": {
                "name": self.launch_name_var.get().strip(),
                "lat": self.launch_lat_var.get().strip(),
                "lon": self.launch_lon_var.get().strip(),
            },
            "trail": trail,
        }
        (self.public_dir / DATA_FILE).write_text(json.dumps(payload, separators=(",", ":")), encoding="utf-8")
        index_path = self.public_dir / INDEX_FILE
        if not index_path.exists():
            index_path.write_text(map_html(), encoding="utf-8")

    def start_map_server(self):
        if self.map_server:
            return

        handler = make_map_handler(self.public_dir)
        try:
            self.map_server = ReusableThreadingHTTPServer(("127.0.0.1", MAP_SERVER_PORT), handler)
        except OSError as exc:
            try:
                self.map_server = ReusableThreadingHTTPServer(("127.0.0.1", 0), handler)
            except OSError as fallback_exc:
                messagebox.showerror(
                    APP_TITLE,
                    f"Could not start local map server on port {MAP_SERVER_PORT}: {exc}\n\nFallback also failed: {fallback_exc}",
                )
                return

        self.map_server_port = self.map_server.server_address[1]
        self.map_server_thread = threading.Thread(target=self.map_server.serve_forever, daemon=True)
        self.map_server_thread.start()
        self.status_var.set(f"Map server running at http://127.0.0.1:{self.map_server_port}/{INDEX_FILE}")

    def open_map(self):
        self.ensure_public_site()
        self.start_map_server()
        if self.map_server:
            url = f"http://127.0.0.1:{self.map_server_port}/{INDEX_FILE}"
            try:
                if sys.platform == "win32":
                    os.startfile(url)
                elif not webbrowser.open(url):
                    raise RuntimeError("No browser accepted the map URL.")
            except Exception as exc:
                self.clipboard_clear()
                self.clipboard_append(url)
                messagebox.showerror(APP_TITLE, f"Could not open the map browser window: {exc}\n\nMap URL copied to clipboard:\n{url}")

    def on_auto_publish_changed(self):
        self.save_settings()
        if self.auto_publish_var.get():
            self.status_var.set("Auto publish enabled")
        else:
            self.status_var.set("Auto publish disabled")

    def publish_now(self):
        self.save_settings()
        self.ensure_public_site()
        site_id = self.netlify_site_var.get().strip()
        token = self.netlify_token_var.get().strip()
        if not site_id or not token:
            self.status_var.set("Netlify site ID and token are required to publish")
            return

        public_dir = str(self.public_dir)
        self.status_var.set("Publishing to Netlify...")
        threading.Thread(target=self.run_netlify_publish, args=(public_dir, site_id, token), daemon=True).start()

    def run_netlify_publish(self, public_dir: str, site_id: str, token: str):
        cmd = [
            "npx",
            "netlify-cli",
            "deploy",
            "--prod",
            "--dir",
            public_dir,
            "--site",
            site_id,
            "--auth",
            token,
        ]
        try:
            result = subprocess.run(cmd, capture_output=True, text=True, timeout=120)
            if result.returncode != 0:
                detail = (result.stderr or result.stdout or "Netlify publish failed").strip()
                self.serial_queue.put(("status", f"Netlify publish failed: {detail[:160]}"))
            else:
                self.serial_queue.put(("status", "Published to Netlify"))
        except FileNotFoundError:
            self.serial_queue.put(("status", "Netlify publishing needs Node.js/npx installed"))
        except Exception as exc:
            self.serial_queue.put(("status", f"Netlify publish failed: {exc}"))

    def export_csv(self):
        if not self.all_points:
            messagebox.showwarning(APP_TITLE, "No telemetry data to export yet.")
            return

        default_name = self.default_export_name("csv")
        path = filedialog.asksaveasfilename(
            title="Save Flight CSV",
            defaultextension=".csv",
            initialfile=default_name,
            filetypes=[("CSV files", "*.csv"), ("All files", "*.*")],
        )
        if not path:
            return

        try:
            with open(path, "w", newline="", encoding="utf-8") as fh:
                writer = csv.DictWriter(fh, fieldnames=EXPORT_FIELDS)
                writer.writeheader()
                for point in self.all_points:
                    writer.writerow(self.point_export_row(point))
        except Exception as exc:
            messagebox.showerror(APP_TITLE, f"Could not save CSV: {exc}")
            return

        self.status_var.set(f"Saved CSV: {path}")

    def export_kml(self):
        valid_points = [point for point in self.all_points if point.gps_valid]
        if not valid_points:
            messagebox.showwarning(APP_TITLE, "No valid GPS points to export yet.")
            return

        default_name = self.default_export_name("kml")
        path = filedialog.asksaveasfilename(
            title="Save Flight KML",
            defaultextension=".kml",
            initialfile=default_name,
            filetypes=[("KML files", "*.kml"), ("All files", "*.*")],
        )
        if not path:
            return

        try:
            Path(path).write_text(build_kml(valid_points), encoding="utf-8")
        except Exception as exc:
            messagebox.showerror(APP_TITLE, f"Could not save KML: {exc}")
            return

        self.status_var.set(f"Saved KML: {path}")

    def default_export_name(self, extension: str) -> str:
        if self.latest_point:
            stamp = f"{self.latest_point.date_utc}_{self.latest_point.time_utc}".replace(":", "")
        else:
            stamp = time.strftime("%Y-%m-%d_%H%M%S", time.gmtime())
        return f"yellowstone_flight_{stamp}.{extension}"


def map_html() -> str:
    return """<!doctype html>
<html>
<head>
  <meta charset="utf-8">
  <meta name="viewport" content="width=device-width, initial-scale=1">
  <title>Yellowstone Live Map</title>
  <link rel="stylesheet" href="https://unpkg.com/leaflet@1.9.4/dist/leaflet.css">
  <script src="https://unpkg.com/leaflet@1.9.4/dist/leaflet.js"></script>
  <style>
    html, body, #map { height: 100%; margin: 0; }
    .hud {
      position: absolute;
      top: 12px;
      right: 12px;
      z-index: 1000;
      background: rgba(255, 255, 255, 0.92);
      border: 1px solid #d5d9df;
      border-radius: 6px;
      padding: 10px 12px;
      min-width: 240px;
      font: 14px/1.35 system-ui, -apple-system, BlinkMacSystemFont, "Segoe UI", sans-serif;
      box-shadow: 0 6px 18px rgba(0,0,0,0.12);
    }
    .hud strong { display: block; margin-bottom: 4px; }
  </style>
</head>
<body>
  <div id="map"></div>
  <div class="hud" id="hud">
    <strong>Yellowstone</strong>
    Waiting for telemetry
  </div>
  <script>
    const map = L.map('map').setView([0, 0], 2);
    L.tileLayer('https://{s}.tile.openstreetmap.org/{z}/{x}/{y}.png', {
      maxZoom: 19,
      attribution: '&copy; OpenStreetMap contributors'
    }).addTo(map);

    let marker = null;
    let trail = L.polyline([], {color: '#0b63ce', weight: 3}).addTo(map);
    let firstFix = true;

    async function refresh() {
      try {
        const response = await fetch('data.json?cache=' + Date.now());
        const data = await response.json();
        const latest = data.latest;
        const display = data.latest_display || {};
        const launch = data.launch_reference || {};
        const points = (data.trail || []).filter(p => Number(p.gps_valid) === 1);
        const latlngs = points.map(p => [Number(p.lat), Number(p.lon)]);
        trail.setLatLngs(latlngs);

        if (latest && Number(latest.gps_valid) === 1) {
          const pos = [Number(latest.lat), Number(latest.lon)];
          if (!marker) marker = L.marker(pos).addTo(map);
          marker.setLatLng(pos);
          marker.bindPopup(
            `Lat: ${latest.lat}<br>Lon: ${latest.lon}<br>` +
            `GPS Alt: ${latest.gps_alt_m} m / ${latest.gps_alt_ft} ft<br>` +
            `Pressure Alt: ${latest.pressure_alt_m} m / ${latest.pressure_alt_ft} ft<br>` +
            `Corrected Alt: ${Number(display.corrected_pressure_alt_m || 0).toFixed(0)} m / ${Number(display.corrected_pressure_alt_ft || 0).toFixed(1)} ft<br>` +
            `Speed: ${latest.ground_speed_mps} m/s / ${latest.ground_speed_mph} mph<br>` +
            `UTC: ${latest.date_utc} ${latest.time_utc}`
          );
          if (firstFix) {
            map.setView(pos, 14);
            firstFix = false;
          } else {
            map.panTo(pos, {animate: true});
          }
          document.getElementById('hud').innerHTML =
            `<strong>Yellowstone</strong>` +
            `Packet: ${latest.packet}<br>` +
            `UTC: ${latest.date_utc} ${latest.time_utc}<br>` +
            `GPS Alt: ${latest.gps_alt_m} m / ${latest.gps_alt_ft} ft<br>` +
            `Pressure Alt: ${latest.pressure_alt_m} m / ${latest.pressure_alt_ft} ft<br>` +
            `Corrected Alt: ${Number(display.corrected_pressure_alt_m || 0).toFixed(0)} m / ${Number(display.corrected_pressure_alt_ft || 0).toFixed(1)} ft<br>` +
            `Speed: ${latest.ground_speed_mps} m/s / ${latest.ground_speed_mph} mph<br>` +
            `V/S: ${latest.vertical_speed_mps} m/s / ${latest.vertical_speed_fpm} fpm<br>` +
            `Heading: ${latest.heading_deg}&deg;<br>` +
            `Pressure: ${latest.pressure_hpa} hPa / ${latest.pressure_inhg} inHg<br>` +
            `RSSI: ${latest.rssi} dBm<br>` +
            `Sats: ${latest.sats}` +
            ((display.distance_km !== null && display.distance_km !== undefined && launch.lat && launch.lon)
              ? `<br>From ${launch.name || 'launch'}: ${Number(display.distance_nm).toFixed(2)} nm @ ${Number(display.bearing_deg_from_launch).toFixed(1)}&deg; / ${Number(display.distance_mi).toFixed(2)} mi / ${Number(display.distance_km).toFixed(2)} km`
              : ``);
        } else {
          document.getElementById('hud').innerHTML =
            `<strong>Yellowstone</strong>Waiting for valid GPS fix`;
        }
      } catch (err) {
        document.getElementById('hud').innerHTML =
          `<strong>Yellowstone</strong>Waiting for data`;
      }
    }

    refresh();
    setInterval(refresh, 3000);
  </script>
</body>
</html>
"""


def build_kml(points):
    first = points[0]
    last = points[-1]
    name = f"Yellowstone Flight {first.date_utc} {first.time_utc} UTC"
    coordinates = "\n".join(f"{p.lon:.7f},{p.lat:.7f},{p.gps_alt_m}" for p in points)

    placemarks = []
    for index, point in enumerate(points):
        if index not in (0, len(points) - 1) and index % 25 != 0:
            continue
        title = "Start" if index == 0 else "End" if index == len(points) - 1 else f"Point {point.packet}"
        description = (
            f"UTC: {point.date_utc} {point.time_utc}<br>"
            f"Packet: {point.packet}<br>"
            f"GPS altitude: {point.gps_alt_m} m / {point.gps_alt_ft:.1f} ft<br>"
            f"Pressure altitude: {point.pressure_alt_m} m / {point.pressure_alt_ft:.1f} ft<br>"
            f"Speed: {point.ground_speed_mps:.2f} m/s / {point.ground_speed_mph:.2f} mph<br>"
            f"Heading: {point.heading_deg:.1f} deg<br>"
            f"RSSI: {point.rssi} dBm<br>"
            f"Satellites: {point.sats}"
        )
        placemarks.append(
            f"""
    <Placemark>
      <name>{html.escape(title)}</name>
      <description><![CDATA[{description}]]></description>
      <Point>
        <coordinates>{point.lon:.7f},{point.lat:.7f},{point.gps_alt_m}</coordinates>
      </Point>
    </Placemark>"""
        )

    return f"""<?xml version="1.0" encoding="UTF-8"?>
<kml xmlns="http://www.opengis.net/kml/2.2">
  <Document>
    <name>{html.escape(name)}</name>
    <Style id="flightPath">
      <LineStyle>
        <color>ffce630b</color>
        <width>4</width>
      </LineStyle>
    </Style>
    <Placemark>
      <name>Flight Path</name>
      <description><![CDATA[
        Start: {html.escape(first.date_utc)} {html.escape(first.time_utc)} UTC<br>
        End: {html.escape(last.date_utc)} {html.escape(last.time_utc)} UTC<br>
        Points: {len(points)}
      ]]></description>
      <styleUrl>#flightPath</styleUrl>
      <LineString>
        <tessellate>1</tessellate>
        <altitudeMode>absolute</altitudeMode>
        <coordinates>
{coordinates}
        </coordinates>
      </LineString>
    </Placemark>
    {''.join(placemarks)}
  </Document>
</kml>
"""


if __name__ == "__main__":
    GroundStationApp().mainloop()
