Altitude-Unknown/YELLOWSTONE/Yellowstone_SD_Arduino_Test/Yellowstone_SD_Arduino_Test.ino

/*
  SD card read/write

  This example shows how to read and write data to and from an SD card file.
*/

#include <SPI.h>
#include <SD.h>

File myFile;

void setup() {
  Serial.begin(9600);
  while (!Serial) {
    ; // wait for serial port to connect. Needed for native USB port only
  }

  Serial.print("Initializing SD card...");

  if (!SD.begin(10)) {
    Serial.println("initialization failed!");
    while (1);
  }
  Serial.println("initialization done.");

  myFile = SD.open("test.txt", FILE_WRITE);

  if (myFile) {
    Serial.print("Writing to test.txt...");
    myFile.println("testing 1, 2, 3.");
    myFile.close();
    Serial.println("done.");
  } else {
    Serial.println("error opening test.txt");
  }

  myFile = SD.open("test.txt");
  if (myFile) {
    Serial.println("test.txt:");

    while (myFile.available()) {
      Serial.write(myFile.read());
    }
    myFile.close();
  } else {
    Serial.println("error opening test.txt");
  }
}

void loop() {
}
