Altitude-Unknown/YELLOWSTONE/(commit log)

2026-06-20 Add YELLOWSTONE PCB schematic
2026-06-20 Document YELLOWSTONE PCB schematic
2026-06-30 Update Yellowstone ground telemetry v3 support
2026-07-01 Add cutdown command chain firmware and lab notes
2026-07-15 Fix ground station exports and Windows commands
    [test_yellowstone_ground_station.py, yellowstone_ground_station.py]
2026-07-17 Fix Windows telemetry table layout
    [test_yellowstone_ground_station.py, yellowstone_ground_station.py]
2026-11-01 Add ASCEND Logger firmware, shared library and PCB design files
    ASCEND/ holds the ASCEND air-quality logger work: the ASCEND_UAS logger and
    ASCEND_Ground receiver sketches, the ASCEND_Logger_Diagnostic and
    ASCEND_SD_Verify bench sketches, the shared ASCENDCore library, bench
    captures, and the ASCEND Logger v11 schematic and EAGLE board files.
    Previously only on the development laptop; committed to back it up.
2026-11-02 Move the ASCEND Logger to its own repository
    The ASCEND Logger firmware, shared library and PCB files now live,
    with their history, at https://github.com/Altitude-Unknown/ASCEND-Logger.
    YELLOWSTONE stays the balloon tracking and termination board.
